dlgus0630/Project03_SelfDrivingCar/remote/Core/Src/main.c

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
/* Includes ------------------------------------------------------------------*/
#include "main.h"
#include "cmsis_os.h"
#include "can.h"
#include "i2c.h"
#include "usart.h"
#include "gpio.h"

/* USER CODE BEGIN Includes */
#include <stdio.h>
/* USER CODE END Includes */

/* USER CODE BEGIN PD */
/* CAN 수신 원형 버퍼의 칸 수.
   인터럽트가 빠르게 받아 담아두고 태스크가 천천히 꺼내 가므로
   잠깐 몰리는 것만 견디면 되어 8칸이면 충분하다. */
#define CAN_RX_RING_SIZE   8u
/* USER CODE END PD */


/* USER CODE BEGIN PV */
/* ===== CAN 수신 원형 버퍼 =====
   수신 인터럽트(ISR)가 head 를 밀면서 쓰고,
   CanRxTask 가 tail 을 밀면서 읽는다.
   쓰는 쪽 하나, 읽는 쪽 하나뿐이므로(생산자 1 : 소비자 1)
   인터럽트를 잠그지 않아도 서로 충돌하지 않는다.
   인터럽트가 값을 바꾸는 변수들이므로 컴파일러가 레지스터에
   캐시해 두지 못하도록 전부 volatile 로 선언한다. */
static volatile CanRxFrame_t g_can_ring[CAN_RX_RING_SIZE];
static volatile uint16_t     g_can_head     = 0;  /* 인터럽트가 다음에 쓸 칸 */
static volatile uint16_t     g_can_tail     = 0;  /* 태스크가 다음에 읽을 칸 */
static volatile uint32_t     g_can_total    = 0;  /* 총 수신 개수 */
static volatile uint32_t     g_can_overflow = 0;  /* 버퍼가 꽉 차서 버린 개수 */

/* ===== 디버거 관찰용 진단 변수 (Live Expressions) =====
   USB-TTL 시리얼 어댑터가 없어 printf 출력을 볼 수 없을 때,
   STM32CubeIDE 의 Live Expressions 창(디버깅 중에 변수 값을 실시간으로 보는 기능)에
   아래 이름을 그대로 적어 넣으면 값이 보인다.

   주의 1) static 을 붙이지 않는다.
             static 은 "이 파일 안에서만 보이게 하라"는 뜻이라,
             디버거가 이름으로 변수를 못 찾는 경우가 생긴다.
   주의 2) volatile 은 반드시 붙인다.
             이것이 없으면 컴파일러가 "어차피 아무도 안 읽는 값"이라고 판단해
             대입 문장 자체를 지워버리거나 레지스터에만 담아두어
             메모리를 들여다보는 디버거에게는 엉뚱한 값이 보인다. */

/* I2C 스캔에서 응답한 장치 총 개수 */
volatile uint8_t  g_diag_i2c_found        = 0u;
/* 응답한 주소 목록 (최대 8개까지, 나머지 칸은 0) */
volatile uint8_t  g_diag_i2c_addr[8]      = {0u};
/* IMU 주소. 0x68 이 응답하면 0x68, 못 찾으면 0 */
volatile uint8_t  g_diag_imu_addr         = 0u;
/* WHO_AM_I(0x75) 레지스터에서 읽은 값. 못 읽으면 0xFF */
volatile uint8_t  g_diag_who_am_i         = 0xFFu;
/* 칩이 어떤 모델인지 판별한 결과 코드
     0 = 못 찾음
     1 = MPU-9250 (WHO_AM_I 값 0x71, 9축·나침반 있음)
     2 = MPU-9255 (WHO_AM_I 값 0x73, 9축·나침반 있음)
     3 = MPU-6500 (WHO_AM_I 값 0x70, 6축·나침반 없음)
     4 = MPU-6050 (WHO_AM_I 값 0x68, 6축·나침반 없음)
     9 = 알 수 없는 칩 */
volatile uint8_t  g_diag_imu_kind         = 0u;
/* I2C 스캔이 끝나면 1 이 된다 */
volatile uint8_t  g_diag_scan_done        = 0u;

/* CAN 총 수신 개수 */
volatile uint32_t g_diag_can_total        = 0u;
/* 마지막으로 받은 프레임의 ID */
volatile uint32_t g_diag_can_last_id      = 0u;
/* 마지막으로 받은 프레임의 데이터 길이 (0~8) */
volatile uint8_t  g_diag_can_last_dlc     = 0u;
/* 마지막으로 받은 프레임의 데이터 8바이트 */
volatile uint8_t  g_diag_can_last_data[8] = {0u};
/* 직전 1초 동안 받은 개수 */
volatile uint32_t g_diag_can_per_sec      = 0u;

/* ===== CAN 통신 장애 원인 판별용 진단 변수 =====
   수신이 전혀 안 될 때(g_diag_can_per_sec 가 계속 0),
   원인이 "MCU 안쪽 설정"인지 "바깥 배선·트랜시버·상대 노드"인지
   갈라내기 위한 값들이다. 전부 Live Expressions 로 관찰한다.
   앞의 진단 변수들과 같은 이유로 static 을 붙이지 않고 volatile 만 붙인다. */

/* HAL_CAN_Start() 가 성공해서 지금 정상 모드로 돌고 있으면 1, 아니면 0 */
volatile uint8_t  g_diag_can_started      = 0u;
/* 수신 필터 설정(HAL_CAN_ConfigFilter)이 성공했으면 1 */
volatile uint8_t  g_diag_can_filter_ok    = 0u;
/* 수신 인터럽트 켜기(HAL_CAN_ActivateNotification)가 성공했으면 1 */
volatile uint8_t  g_diag_can_notify_ok    = 0u;

/* ===== CAN_ESR(오류 상태 레지스터)에서 뽑아낸 값들 =====
   RM0008(STM32F1 참조매뉴얼)의 CAN_ESR 비트 배치는 다음과 같다.
     비트 31~24 : REC[7:0]  수신 오류 카운터
     비트 23~16 : TEC[7:0]  송신 오류 카운터
     비트  6~4  : LEC[2:0]  마지막 오류 코드
     비트  3    : (예약, 쓰지 않음)
     비트  2    : BOFF      버스오프 상태
     비트  1    : EPVF      오류 수동(Error Passive) 상태
     비트  0    : EWGF      오류 경고(Error Warning) 상태
   [확인 기록] 작업 지시서의 표에는 TEC 가 24~31비트, REC 가 16~23비트라고
   적혀 있었으나 이는 둘이 서로 뒤바뀐 것이다. RM0008 기준으로는 위가 맞다.
   그래서 값을 뽑아내는 코드도 TEC 는 16비트에서, REC 는 24비트에서
   잘라내도록 해 두었다(freertos.c 의 Can_UpdateErrorDiag 참고). */

/* 송신 오류 카운터 (ESR 비트 23~16).
   보낸 프레임이 실패할 때마다 8씩 오른다.
   아무도 응답(ACK)해 주지 않는 상황이면 순식간에 128 까지 치솟는다. */
volatile uint8_t  g_diag_can_tec          = 0u;
/* 수신 오류 카운터 (ESR 비트 31~24).
   받는 쪽에서 어긋난 프레임을 볼 때마다 오른다.
   상대가 아예 아무것도 안 보내면 이 값은 0 에서 그대로 멈춰 있다. */
volatile uint8_t  g_diag_can_rec          = 0u;
/* 마지막 오류 코드 (ESR 비트 6~4). 값의 뜻은 아래 표와 같다.
     0 = 오류 없음
     1 = 스터프 오류 (같은 값이 6비트 내리 나왔다.
                      두 노드의 통신 속도(보율)가 서로 다를 때 잘 난다)
     2 = 폼 오류     (프레임의 정해진 모양이 어긋났다)
     3 = ACK 오류    (응답해 주는 노드가 하나도 없다.
                      상대가 꺼져 있거나, 트랜시버·배선·종단저항 문제다)
     4 = 비트 리세시브 오류 (1 을 내보냈는데 버스에서는 0 으로 읽혔다)
     5 = 비트 도미넌트 오류 (0 을 내보냈는데 버스에서는 1 로 읽혔다.
                             보통 트랜시버가 안 물려 있거나 배선이 끊긴 경우다)
     6 = CRC 오류    (검사값이 어긋났다)
     7 = 소프트웨어가 직접 써 넣은 값 (하드웨어가 낸 오류가 아니다) */
volatile uint8_t  g_diag_can_lec          = 0u;
/* 버스오프 상태면 1 (ESR 비트 2).
   송신 오류가 255 를 넘어서 컨트롤러가 스스로 버스에서 빠져나간 상태다. */
volatile uint8_t  g_diag_can_boff         = 0u;
/* 오류 수동(Error Passive) 상태면 1 (ESR 비트 1) */
volatile uint8_t  g_diag_can_epvf         = 0u;
/* 오류 경고(Error Warning) 상태면 1 (ESR 비트 0) */
volatile uint8_t  g_diag_can_ewgf         = 0u;
/* ESR 레지스터를 가공하지 않은 원본값 그대로.
   위의 낱개 값들이 미덥지 않을 때 이 값을 직접 들여다보면 된다. */
volatile uint32_t g_diag_can_esr_raw      = 0u;
/* HAL_CAN_GetError() 가 알려주는, HAL 계층이 모아 둔 오류값 */
volatile uint32_t g_diag_can_hal_err      = 0u;

/* ===== 루프백 자기진단 결과 =====
   루프백은 트랜시버도 바깥 배선도 없이,
   자기가 내보낸 프레임을 자기가 되받아 보는 시험 모드다.
   여기서 성공(1)이 나오면 클럭·비트타이밍(통신 속도)·필터·인터럽트 같은
   MCU 안쪽 설정이 전부 정상이라는 뜻이고,
   남은 원인은 바깥(트랜시버·배선·종단저항·상대 노드)뿐으로 좁혀진다.
     0 = 아직 실행 안 함
     1 = 성공 (MCU 안쪽은 정상)
     2 = 송신 실패 (송신함에 프레임을 넣지 못했다)
     3 = 수신 타임아웃 (내보냈지만 100ms 안에 되돌아오지 않았다)
     4 = 시험용 프레임이 안 되돌아옴 (남의 프레임은 들어왔지만,
         내가 보낸 0x7FF 시험용 프레임은 100ms 안에 되돌아오지 않았다)
     5 = 수신함에서 꺼내기 실패 (수신함에 뭔가 들어오기는 했는데 꺼내는 데
         실패했고, 시험용 프레임도 끝내 되돌아오지 않았다. 3 과 달리
         "아무것도 안 왔다"가 아니므로 배선이 아니라 수신함을 다루는 쪽을 본다) */
volatile uint8_t  g_diag_can_loopback     = 0u;
/* 루프백 시험을 마치고 정상 모드로 되돌리는 데 성공했으면 1.
   이 값이 0 이면 이후 통신이 영영 안 되는 상태이므로 가장 먼저 확인해야 한다. */
volatile uint8_t  g_diag_can_restore_ok   = 0u;
/* 버스오프에서 소프트웨어로 되살리는 데 온전히 성공한 횟수.
   시도만 하고 실패한 것은 세지 않는다. 실패는 g_diag_can_stuck 이 알려 준다. */
volatile uint32_t g_diag_can_recover_cnt  = 0u;
/* CAN 손잡이(hcan)가 리셋 없이는 되살릴 수 없는 상태에 빠졌으면 1.
   HAL_CAN_Stop() 은 손잡이 상태가 LISTENING 일 때만, HAL_CAN_Start() 는
   READY 일 때만 실제로 하드웨어를 건드린다. 그 밖의 상태에서는 아무 일도
   하지 않고 곧바로 오류만 돌려준다. 그래서 한 번 어긋난 상태로 굳어 버리면
   1초마다 다시 시도해 봐야 매번 헛물만 켤 뿐이고, g_diag_can_recover_cnt 는
   조금도 늘지 않고 그 자리에 멈춰 있는다. 온전히 되살아난 횟수만 세는 값이라
   실패한 시도는 아무리 되풀이해도 반영되지 않기 때문이다.
   Live Expressions 로 지켜볼 때 g_diag_can_stuck 이 1 인데 이 값이 멈춰 있다고
   해서 이상할 것이 없다. "몇 번 시도했는가"가 아니라 "몇 번 되살아났는가"다.
     1 = 그렇게 굳어 버린 상태라 Stop/Start 를 아예 시도조차 못 했거나,
         시도는 했지만 실패했다는 뜻이다. 이때는 MCU 를 리셋해야 풀린다.
     0 = 그런 상태가 아니다.
   지금 형편을 그대로 비추는 값이라, 나중에 복구가 온전히 성공하면 다시 0 이 된다. */
volatile uint8_t  g_diag_can_stuck        = 0u;
/* USER CODE END PV */

void SystemClock_Config(void);
void MX_FREERTOS_Init(void);
/**
  * @brief  The application entry point.
  * @retval int
  */
int main(void)
{

  /* MCU Configuration--------------------------------------------------------*/

  /* Reset of all peripherals, Initializes the Flash interface and the Systick. */
  HAL_Init();

  /* Configure the system clock */
  SystemClock_Config();

  /* Initialize all configured peripherals */
  MX_GPIO_Init();
  MX_CAN_Init();
  MX_I2C1_Init();
  MX_USART1_UART_Init();
  /* USER CODE BEGIN 2 */
  /* printf 로 찍은 글자가 버퍼에 쌓여 있다가 화면에 안 나오는 일을 막는다.
     _IONBF 는 "버퍼를 쓰지 않는다"는 뜻으로, 한 글자 생길 때마다 바로 보낸다.
     진단용 코드에서는 보드가 멈춰버려도 그 직전까지 찍힌 내용이
     그대로 남아 있어야 원인을 찾을 수 있다. */
  setvbuf(stdout, NULL, _IONBF, 0);

  /* 부팅 배너 - 지금 켜진 보드가 어느 쪽인지 한눈에 알아보기 위한 것 */
  printf("\r\n========================================\r\n");
  printf(" Project03_Remote (조종 노드) 시작\r\n");
  printf(" CAN 500kbps / I2C1 400kHz / UART 115200\r\n");
  printf("========================================\r\n");

  /* ===== CAN 수신 필터 설정 =====
     마스크를 0으로 두면 ID 를 비교하는 자리가 하나도 없어져서
     결과적으로 모든 ID 가 통과한다.
     지금은 진단이 목적이라 버스에 실제로 어떤 ID 가 흐르고 있는지를
     눈으로 전부 확인해야 하므로 일부러 전부 통과시킨다. */
  CAN_FilterTypeDef can_filter = {0};
  can_filter.FilterBank           = 0;
  can_filter.FilterMode           = CAN_FILTERMODE_IDMASK;
  can_filter.FilterScale          = CAN_FILTERSCALE_32BIT;
  can_filter.FilterIdHigh         = 0x0000;
  can_filter.FilterIdLow          = 0x0000;
  can_filter.FilterMaskIdHigh     = 0x0000;   /* 마스크 0 = 전부 통과 */
  can_filter.FilterMaskIdLow      = 0x0000;
  can_filter.FilterFIFOAssignment = CAN_FILTER_FIFO0;
  can_filter.FilterActivation     = ENABLE;
  can_filter.SlaveStartFilterBank = 14;

  /* 아래 세 가지는 실패하더라도 Error_Handler() 로 보내지 않는다.
     Error_Handler() 는 인터럽트를 모두 끄고 무한루프에 갇히기 때문에,
     CAN 트랜시버를 연결하지 않은 채 전원을 켜면 보드가 통째로 먹통이 되어
     UART 로그조차 한 줄도 안 나온다. 그러면 무엇이 잘못됐는지 알 수 없다.
     그래서 실패했다는 사실만 화면에 알리고,
     나머지 진단(I2C 스캔 등)은 그대로 이어서 진행하도록 한다. */
  if (HAL_CAN_ConfigFilter(&hcan, &can_filter) != HAL_OK)
  {
    printf("[CAN] 필터 설정 실패 (그래도 계속 진행합니다)\r\n");
  }
  else
  {
    g_diag_can_filter_ok = 1u;   /* 디버거에서 볼 수 있게 성공 여부를 남긴다 */
  }
  if (HAL_CAN_Start(&hcan) != HAL_OK)
  {
    printf("[CAN] 시작 실패 - 트랜시버 연결과 배선을 확인하세요 (그래도 계속 진행합니다)\r\n");
  }
  else
  {
    g_diag_can_started = 1u;
  }
  if (HAL_CAN_ActivateNotification(&hcan, CAN_IT_RX_FIFO0_MSG_PENDING) != HAL_OK)
  {
    printf("[CAN] 수신 인터럽트 켜기 실패 (그래도 계속 진행합니다)\r\n");
  }
  else
  {
    g_diag_can_notify_ok = 1u;
    printf("[CAN] 준비 완료 - 모든 ID 를 통과시키는 필터로 대기합니다\r\n");
  }
  /* USER CODE END 2 */

  /* Call init function for freertos objects (in cmsis_os2.c) */
  MX_FREERTOS_Init();

  /* Start scheduler */
  osKernelStart();

  /* We should never get here as control is now taken by the scheduler */

  /* Infinite loop */
  /* USER CODE BEGIN WHILE */
  while (1)
  {
    /* USER CODE END WHILE */

    /* USER CODE BEGIN 3 */
  }
  /* USER CODE END 3 */
}

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
/* USER CODE BEGIN 4 */
/**
  * @brief  printf 가 글자 하나를 내보낼 때 호출되는 함수.
  *         syscalls.c 안의 _write() 가 글자마다 이 함수를 부른다.
  *         여기서 USART1 로 실제 전송하므로, 이 함수만 있으면
  *         printf 출력이 디버그용 시리얼 창에 그대로 나타난다.
  */
int __io_putchar(int ch)
{
  /* ch 는 int 지만 실제로 보낼 것은 맨 아래 1바이트뿐이다 */
  HAL_UART_Transmit(&huart1, (uint8_t *)&ch, 1, 100);
  return ch;
}

/**
  * @brief  CAN 수신 FIFO0 에 프레임이 도착했을 때 자동으로 불리는 함수(인터럽트).
  *
  *         [중요] 이 안에서는 절대로 printf 를 부르지 않는다.
  *         printf 는 UART 로 한 글자씩 다 나갈 때까지 기다리는 방식이라
  *         인터럽트가 그만큼 오래 붙잡혀 있게 되고,
  *         그 사이에 들어온 다음 프레임을 놓쳐버린다.
  *         그래서 여기서는 원형 버퍼에 담아두고 개수만 세고 곧바로 빠져나오며,
  *         실제 화면 출력은 CanRxTask 가 여유 있을 때 대신 처리한다.
  */
void HAL_CAN_RxFifo0MsgPendingCallback(CAN_HandleTypeDef *hcan_arg)
{
  CAN_RxHeaderTypeDef header;
  uint8_t             rx_data[8];
  uint16_t            head;
  uint16_t            next;
  uint8_t             i;

  /* 하드웨어 수신함에서 프레임을 꺼낸다 */
  if (HAL_CAN_GetRxMessage(hcan_arg, CAN_RX_FIFO0, &header, rx_data) != HAL_OK)
  {
    return;
  }

  /* 총 수신 개수는 버퍼가 꽉 찼든 아니든 항상 센다 */
  g_can_total++;

  /* 디버거(Live Expressions)로 볼 진단용 값도 여기서 같이 갱신한다.
     인터럽트 안이므로 printf 는 절대 부르지 않고 단순 대입만 한다.
     아래는 원형 버퍼가 가득 차서 버리는 경우보다 앞에 두었다.
     버려지더라도 "버스에 지금 무엇이 흘러오는가"는 보여야 하기 때문이다. */
  g_diag_can_total    = g_can_total;
  g_diag_can_last_id  = (header.IDE == CAN_ID_STD) ? header.StdId : header.ExtId;
  g_diag_can_last_dlc = (uint8_t)header.DLC;
  for (i = 0u; i < 8u; i++)
  {
    g_diag_can_last_data[i] = rx_data[i];
  }

  head = g_can_head;
  next = (uint16_t)(head + 1u);
  if (next >= CAN_RX_RING_SIZE)
  {
    next = 0u;
  }

  if (next == g_can_tail)
  {
    /* 버퍼가 가득 찼다. 이번 프레임은 버리고 버린 개수만 따로 센다. */
    g_can_overflow++;
    return;
  }

  if (header.IDE == CAN_ID_STD)
  {
    g_can_ring[head].Id    = header.StdId;   /* 표준 11비트 ID */
    g_can_ring[head].IsExt = 0u;
  }
  else
  {
    g_can_ring[head].Id    = header.ExtId;   /* 확장 29비트 ID */
    g_can_ring[head].IsExt = 1u;
  }
  g_can_ring[head].Dlc = (uint8_t)header.DLC;

  for (i = 0u; i < 8u; i++)
  {
    g_can_ring[head].Data[i] = rx_data[i];
  }

  /* 내용을 다 채운 뒤에 마지막으로 head 를 옮긴다.
     읽는 쪽이 아직 덜 채워진 칸을 먼저 보게 되는 것을 막기 위한 순서다. */
  g_can_head = next;
}

/**
  * @brief  원형 버퍼에서 CAN 프레임을 하나 꺼낸다. (CanRxTask 전용)
  * @retval 1 = 하나 꺼냈음, 0 = 버퍼가 비어 있음
  */
uint8_t CanRx_Pop(CanRxFrame_t *out)
{
  uint16_t tail;
  uint8_t  i;

  if (out == NULL)
  {
    return 0u;
  }

  tail = g_can_tail;
  if (tail == g_can_head)
  {
    return 0u;   /* 비어 있음 */
  }

  /* volatile 인 버퍼에서 일반 변수로 한 항목씩 옮겨 담는다 */
  out->Id    = g_can_ring[tail].Id;
  out->IsExt = g_can_ring[tail].IsExt;
  out->Dlc   = g_can_ring[tail].Dlc;
  for (i = 0u; i < 8u; i++)
  {
    out->Data[i] = g_can_ring[tail].Data[i];
  }

  tail = (uint16_t)(tail + 1u);
  if (tail >= CAN_RX_RING_SIZE)
  {
    tail = 0u;
  }
  g_can_tail = tail;   /* 다 옮긴 뒤에 tail 을 옮긴다 */

  return 1u;
}

/**
  * @brief  부팅 후 지금까지 받은 CAN 프레임 총 개수를 알려준다.
  */
uint32_t CanRx_GetTotal(void)
{
  return g_can_total;
}

/**
  * @brief  원형 버퍼가 가득 차서 버려진 프레임 개수를 알려준다.
  *         이 값이 계속 늘어난다면 출력이 수신 속도를 못 따라가고 있다는 뜻이다.
  */
uint32_t CanRx_GetOverflow(void)
{
  return g_can_overflow;
}
/* USER CODE END 4 */
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
