dlgus0630/Project03_SelfDrivingCar/vehicle/ASW/Inc/asw_autonomous.h

/*
 * asw_autonomous.h
 *
 *  Layer  : ASW (Application Software)
 *  Module : ASW_AUTONOMOUS
 *  Desc   : 3개 초음파 센서(좌/전/우) 거리값을 기반으로 한
 *           독립적 자율주행(미로 통과) 판단 로직.
 *           위험/경고 임계값은 "주행 정책"이므로 Driver가 아닌
 *           본 Application 계층에서 관리한다.
 *
 *  Naming Rule : ASW_Autonomous_<Verb><Object>()
 */

#ifndef __ASW_AUTONOMOUS_H
#define __ASW_AUTONOMOUS_H

#include <stdint.h>

/* ------------------------------------------------------------------------
 * 자율주행 판단 임계값 (cm)
 * ------------------------------------------------------------------------ */
#define ASW_AUTO_DIST_EMERGENCY_CM   18u   /* 전방이 이 값 이하 = 아크로도 못 도는 상황,
                                             * 제자리 피벗(비상)으로 전환
                                             * [12->18] 전방 센서는 트리거 순환(좌->전->우,
                                             * 65ms 간격) 때문에 실제로 약 195ms에 한 번만
                                             * 갱신된다. 그 사이 전진한 거리만큼 임계값을
                                             * 앞당겨 반응 시간을 확보 */
#define ASW_AUTO_DIST_TURN_ENTER_CM  48u   /* 전방이 이 값 이하 = 코너 도착,
                                             * 주행을 멈추지 않고 아크 선회 시작
                                             * [36->48] 위와 동일 - 센서 갱신 지연(195ms)
                                             * 동안 전진하는 거리를 선반영해 "벽에 닿은 뒤
                                             * 회전"하는 현상 제거 */
#define ASW_AUTO_DIST_WARNING_CM     30u   /* 후진 회복 완료 판정 등 일반 경고 거리 */
#define ASW_AUTO_DIST_SIDE_BLOCK_CM  10u   /* 좌/우가 모두 이 값 이하 = 회전 여유조차
                                             * 없음 -> 후진 (좁은 통로 오판 방지를 위해
                                             * 낮게 유지) */

/* ------------------------------------------------------------------------
 * 센서 필터링 (지수이동평균, EMA)
 * ------------------------------------------------------------------------ */
#define ASW_AUTO_FILT_FRONT_NEW_W    2u    /* 전방: new 1/2 반영 (반응성 우선) */
#define ASW_AUTO_FILT_SIDE_NEW_W     3u    /* 좌우: new 1/3 반영 */
#define ASW_AUTO_FILT_RISE_MAX_CM    12u   /* 필터값이 한 사이클에 증가할 수 있는 상한.
                                             * 초음파 타임아웃/난반사로 인한 "순간 뻥 뚫림"
                                             * 스파이크가 판단에 섞이는 것을 차단.
                                             * (가까워지는 방향은 안전을 위해 무제한 즉시 반영) */

/* ------------------------------------------------------------------------
 * DRIVE 상태 : 직선 주행 (PD 센터링 + 전방거리 비례 속도)
 * ------------------------------------------------------------------------ */
#define ASW_AUTO_DRIVE_BASE_DUTY     560u  /* 전방 개방 시 최고 속도
                                             * [660->560, 약 15% 감속] 센서 갱신 지연
                                             * 195ms 동안 전진하는 거리 자체를 줄여
                                             * 정지거리를 단축 (반응 시간 확보) */
#define ASW_AUTO_DRIVE_SLOW_DUTY     430u  /* 코너 진입 직전 최저 전진 속도
                                             * (최저 유지값이므로 낮추지 않음 - 더 낮추면
                                             *  L298N 전압강하로 정지마찰을 못 이김) */
#define ASW_AUTO_SPEED_FULL_CM       85u   /* 전방이 이 값 이상이면 최고 속도,
                                             * TURN_ENTER~이 값 사이 선형 보간 감속
                                             * [60->85] TURN_ENTER 상향에 비례해 감속 시작
                                             * 지점도 앞당겨, 코너 도착 전에 충분히 감속 */
#define ASW_AUTO_CENTER_TRUST_CM     60u   /* 이보다 먼 거리는 '벽 없음', 이 값으로 클램프 */
#define ASW_AUTO_CENTER_KP           5u    /* 좌우 거리차 1cm당 보정 duty (P항)
                                             * [3->5] 2차 주행에서 통로 한쪽 벽에 붙어
                                             * 긁히는 현상 -> 센터링 복원력 강화 */
#define ASW_AUTO_CENTER_KD           28u   /* 거리차 변화량당 보정 duty (D항, 위빙 감쇠)
                                             * [20->28] KP 상향에 맞춰 감쇠도 같이 올려
                                             * 위빙(좌우 흔들림) 없이 센터링만 빨라지게 */
#define ASW_AUTO_CENTER_DEADBAND_CM  3     /* |좌-우| 이하이면 보정 0 */
#define ASW_AUTO_CENTER_MAX_CORR     140u  /* 센터링 보정 상한
                                             * [110->140] 게인만 올리고 상한을 그대로 두면
                                             * 곧바로 클리핑돼 강화 효과가 사라진다 */
#define ASW_AUTO_CENTER_DDIFF_MAX    6     /* D항에 넣는 거리차 변화량 상한 (cm/사이클).
                                             * 실제 주행에서 한 사이클에 생길 수 있는 기하학적
                                             * 변화는 2~3cm뿐 - 그 이상은 벽 모서리 통과 등
                                             * "이벤트"이므로 조향 신호로 쓰지 않는다 */
#define ASW_AUTO_STEER_SLEW          70    /* 사이클당 조향 보정 변화 상한 (duty).
                                             * 센서 점프로 인한 조향 채찍질(zigzag) 방지 */
#define ASW_AUTO_DUTY_MIN            220u  /* 센터링 중 바퀴 최소 duty */
#define ASW_AUTO_DUTY_SLEW_STEP      120u  /* 사이클(50ms)당 duty 최대 변화량 */

/* ------------------------------------------------------------------------
 * 회전 방향 투표 (접근 구간 적분)
 *  - 코너에 닿는 "순간"의 좌/우 한 쌍만 보고 방향을 정하면 대각선 박스
 *    난반사 한 방에 오판 -> 반대로 돌아 왔던 길로 U턴(출발지 복귀)한다.
 *  - 전방이 VOTE_CM 미만으로 좁아지는 접근 구간 동안 (좌-우)를 매 사이클
 *    적분한 점수로 방향을 결정 -> 순간 노이즈/난반사에 강함
 * ------------------------------------------------------------------------ */
#define ASW_AUTO_VOTE_CM             65u   /* 전방이 이 값 미만일 때 투표 적분 */
#define ASW_AUTO_VOTE_CLAMP          25    /* 사이클당 (좌-우) 기여 상한 (cm) */
#define ASW_AUTO_VOTE_TH             30    /* |점수|가 이 값 이상일 때만 투표 신뢰,
                                             * 미만이면 진입 순간의 넓은 쪽 사용 */
#define ASW_AUTO_GAP_DECISIVE_CM     30    /* 결정 순간 좌우 차이가 이 이상이면(한쪽이
                                             * 통로 입구처럼 확실히 열림) 적분 점수보다
                                             * 현재값을 우선 (상승제한 필터를 통과한 값이라
                                             * 순간 난반사로는 이만큼 벌어질 수 없음) */
#define ASW_AUTO_DIR_LOCK_MS         800u  /* (아래 주석 참조) */
#define ASW_AUTO_VOTE_OPEN_CM        45    /* 좌/우 중 한쪽이 이 값 이상일 때만 투표 적분.
                                             * 통로 안 양쪽 벽의 사소한 비대칭(13 vs 26cm 등)은
                                             * 방향 근거가 아님 - "입구가 보인다"는 신호만 적분 */
#define ASW_AUTO_CREEP_DUTY          400u  /* 방향 미확정 상태로 코너에 도달했을 때
                                             * 개방 신호를 기다리며 저속 전진하는 속도 */
#define ASW_AUTO_CREEP_FLOOR_CM      26u   /* [20->26] EMERGENCY 상향(12->18)에 맞춰 같이
                                             * 올림. 그대로 두면 CREEP과 비상 피벗 사이
                                             * 여유가 2cm뿐이라 creep이 사실상 사라진다.
                                             * 전방이 이 값 이하가 되면 더 못 기다림 ->
                                             * 그 시점 최선의 정보로 회전 강제 확정 */  /* 직전 회전 종료 후 이 시간 안에 다시 회전이
                                             * 필요해지면 방향 재투표 없이 같은 방향 유지.
                                             * (S자 미로의 연속 코너 2개는 항상 같은 방향
                                             * 회전쌍 -> 중간에 방향이 뒤집히면 U턴) */

/* ------------------------------------------------------------------------
 * ARC_TURN 상태 : 무정지 아크(호) 선회 - 일반 코너의 기본 처리
 *  - 바깥쪽 바퀴 고속 / 안쪽 바퀴 저속으로 전진하며 도는 이동 선회.
 *    정지·피벗 없이 코너를 통과하므로 매끄럽고 빠르다.
 * ------------------------------------------------------------------------ */
#define ASW_AUTO_ARC_OUT_DUTY        520u  /* 바깥쪽 바퀴 duty
                                             * [620->520, 약 15% 감속] 선회 중 전방 센서
                                             * 갱신 지연 대비 - 선회 궤적을 줄여 반응 확보 */
#define ASW_AUTO_ARC_IN_DUTY         320u  /* 안쪽 바퀴 duty (작을수록 급선회)
                                             * (최저 유지값이므로 낮추지 않음) */
#define ASW_AUTO_ARC_EXIT_CM         54u   /* 전방이 이 값 초과(연속 확인)면 선회 종료
                                             * [42->54] TURN_ENTER(48)보다 반드시 커야 한다.
                                             * 작으면 선회 종료 직후 DRIVE가 곧바로 다시
                                             * 코너로 판정해 ARC를 재진입 -> 제자리 반복
                                             * (히스테리시스 +6cm를 기존과 동일하게 유지) */
#define ASW_AUTO_ARC_MIN_MS          200u  /* 최소 선회 유지시간 */
#define ASW_AUTO_ARC_MAX_MS          1500u /* 이 시간 내 전방이 안 열리면 피벗 전환 */

/* ------------------------------------------------------------------------
 * PIVOT 상태 : 제자리 피벗 - 비상시(막다른 코너/급접근)에만 사용
 *  - 방향은 투표로 잠근 방향 유지: 코너에서 올바른 쪽으로 돌면
 *    90도 부근에서 먼저 통로가 열리므로 180도(왔던 길)까지 갈 일이 없다
 * ------------------------------------------------------------------------ */
#define ASW_AUTO_PIVOT_DUTY          420u  /* 피벗 회전 속도 */
#define ASW_AUTO_PIVOT_EXIT_CM       52u   /* 전방이 이 값 초과(연속 확인)면 종료
                                             * [40->52] ARC_EXIT와 같은 이유로 TURN_ENTER(48)
                                             * 위에 두어 피벗 종료 직후 재진입(가다서다) 방지
                                             * (히스테리시스 +4cm를 기존과 동일하게 유지) */
#define ASW_AUTO_PIVOT_MIN_MS        150u  /* 최소 회전 유지시간 */
#define ASW_AUTO_PIVOT_EXPECT_MS     500u  /* 약 90도 회전 예상 소요시간(경험적 추정, 실측 보정 필요).
                                             * 이 시간이 지나도 PIVOT_EXIT_CM 기준을 못 채우면
                                             * 더 도는 대신 느슨한 기준(WARNING_CM)만으로 즉시
                                             * 복귀시켜 왔던 길까지 도는 U턴을 방지한다. */
#define ASW_AUTO_PIVOT_EXPECT_DEG    90.0f /* 위 EXPECT_MS 주석이 이미 말로 적어 둔 "약 90도 회전"
                                             * 가정을 그대로 숫자로 옮긴 값이다. 새로 잡은 임의의
                                             * 튜닝 상수가 아니라, remote IMU yaw로 실제 회전각을
                                             * 잴 수 있게 된 지금 그 가정을 명시적이고 측정 가능한
                                             * 형태로 드러낸 것 - 시간(EXPECT_MS)과 각도(EXPECT_DEG)는
                                             * 같은 "약 90도"를 서로 다른 단위로 표현한 짝이다. */
#define ASW_AUTO_PIVOT_IMU_MAX_AGE_MS 400u /* 각도 기반 과회전 가드가 yaw를 "살아있는 값"으로
                                             * 인정해 주는 최대 수신 경과시간.
                                             * remote IMU 자세는 CAN 0x120으로 약 100ms마다
                                             * 올라오므로 400ms는 프레임 약 4개를 놓쳐도
                                             * 버티는 여유다 - 평상시 지터(버스 혼잡, 한두 개
                                             * 유실)로는 각도 가드가 흔들리지 않을 만큼 길고,
                                             * 링크가 진짜로 죽었을 때는 여러 번의 피벗에
                                             * 걸쳐서가 아니라 그 피벗 안에서 곧바로 감지될
                                             * 만큼 짧다. */
#define ASW_AUTO_PIVOT_MAX_MS        1700u /* 초과 시 '갇힘' -> BACKING_UP */
#define ASW_AUTO_EXIT_CONFIRM        2u    /* 개방 연속 확인 사이클 수 (ARC/PIVOT 공용) */

/* ------------------------------------------------------------------------
 * BACKING_UP 상태 : 연속 후진 회복 (최후 수단)
 * ------------------------------------------------------------------------ */
#define ASW_AUTO_BACKUP_DUTY         450u  /* 후진 속도 */
#define ASW_AUTO_BACKUP_STEP_MS      250u  /* 재시도 카운트 1회로 치는 후진 시간 단위 */
#define ASW_AUTO_BACKUP_MAX_RETRY    3u    /* 누적 후진 한도 -> 반대 방향 피벗 재시도 */

/* CtrlTask의 osDelay(50)과 반드시 일치시켜야 하는 제어 주기 (freertos.c 참조) */
#define ASW_AUTO_CTRL_PERIOD_MS      50u

/* ------------------------------------------------------------------------
 * Public API
 * ------------------------------------------------------------------------ */
void ASW_Autonomous_Init(void);
void ASW_Autonomous_ProcessControl(uint32_t dist_left,
                                 uint32_t dist_front,
                                 uint32_t dist_right);

#endif /* __ASW_AUTONOMOUS_H */
