dlgus0630/Project03_SelfDrivingCar/remote/Core/Inc/mpu9255.h

/**
  ******************************************************************************
  * @file    mpu9255.h
  * @brief   MPU-9255 6축(가속도 + 자이로) 읽기와 상보필터 자세 추정 공개 창구
  ******************************************************************************
  * @attention
  *
  * 이 파일은 STM32CubeMX 가 만들어 주는 파일이 아니라 사람이 직접 쓴 파일이다.
  * 그래서 USER CODE 표시 구역이 따로 없고, 어디를 고쳐도 다시 만들기(Generate Code)
  * 때 지워지지 않는다.
  *
  * [센서를 어떻게 붙여 놓았는가]
  *   보드는 바닥에 평평하게(수평으로) 눕혀 놓았고,
  *   MPU 의 X축이 리모컨의 앞쪽(FRONT)을 향한다.
  *   센서 좌표계는 오른손 좌표계라서 이렇게 정리된다.
  *       X = 앞(forward),  Y = 왼쪽(left),  Z = 위(up)
  *   이 배치를 전제로 아래 상보필터의 roll / pitch 계산식이 세워져 있다.
  *
  * [이 단계에서 지자기(나침반)를 다루지 않는 이유]
  *   MPU-9255 안의 나침반(AK8963)은 같은 칩 안에 있어도 I2C 로는 곧바로 안 보인다.
  *   바이패스를 열거나 보조 I2C 마스터를 돌려야 겨우 읽히는데 손이 많이 간다.
  *   방위각(yaw)은 나침반 없이 자이로 Z축을 적분하는 것만으로 따라간다.
  *   되잡아 줄 절대 기준이 없어 시간이 지나면 흘러가므로, 짧은 구간의
  *   회전량으로만 쓰고 절대 방위로는 쓰지 않는다. 그 용도라면 나침반이
  *   없어도 충분하므로, 나침반은 그대로 통째로 건너뛴다.
  ******************************************************************************
  */

/* Define to prevent recursive inclusion -------------------------------------*/
#ifndef __MPU9255_H__
#define __MPU9255_H__

#ifdef __cplusplus
extern "C" {
#endif

/* Includes ------------------------------------------------------------------*/
/* main.h 가 stm32f1xx_hal.h 를 끌어와 uint8_t / int16_t 같은 형과
   HAL 자료형을 모두 갖춰 준다. 이 헤더 하나만 include 해도 되도록 만들어 둔다. */
#include "main.h"

/* Exported constants --------------------------------------------------------*/

/* 9축 IMU 의 7비트 I2C 주소와, 어떤 칩인지 알려주는 레지스터 번호.
   [왜 이 둘만 헤더로 내놓는가]
   freertos.c 의 부팅 시 I2C 스캔이 이 드라이버를 거치지 않고 직접
   이 주소를 두드려 WHO_AM_I 를 읽어 본다. 스캔은 Mpu9255_Init() 보다
   먼저 도는 자리라 드라이버 함수를 부를 수 없기 때문이다.
   그렇다고 양쪽이 같은 숫자를 따로 적어 두면 한쪽만 고쳤을 때
   소리 없이 어긋나므로, 숫자만 여기 한 곳에 모아 둘이 같이 쓴다.
   (AD0 핀을 GND 에 붙였으므로 0x68 이다. 3.3V 에 붙였다면 0x69 가 된다) */
#define MPU9255_ADDR_7BIT         0x68u
#define MPU9255_REG_WHO_AM_I      0x75u

/* 좌우/앞뒤 기울기의 부호를 통째로 뒤집는 스위치.
   [왜 이런 스위치를 굳이 두는가]
   센서를 실제로 어느 방향으로 붙였는지는 프로젝트 주인이 "이렇게 붙였다"고
   말해 준 것을 그대로 믿고 적어 둔 것일 뿐, 책상 위에서 직접 기울여 보며
   확인한 적이 아직 한 번도 없다. 모듈을 180도 돌려 꽂았거나 뒤집어 붙였다면
   왼쪽으로 기울였는데 오른쪽 값이 나오는 식으로 부호만 정반대가 된다.
   그때 필터 수식을 건드리기 시작하면 수식이 금세 뒤엉켜서 무엇이 옳은지
   알 수 없게 된다. 그러니 실물 시험에서 좌우 또는 앞뒤가 거꾸로 나오거든
   수식은 그대로 두고 여기 값을 0 에서 1 로만 바꾸면 된다. */
#define IMU_ROLL_INVERT           0
#define IMU_PITCH_INVERT          0

/* 상보필터의 배분 비율.
   0.98 = 자이로(짧은 시간은 정확하지만 오래 두면 흘러간다) 98%,
          가속도(길게 보면 정확하지만 흔들림에 약하다) 2% 로 섞는다는 뜻이다. */
#define IMU_ALPHA                 0.98f

/* IMU 태스크가 한 번 도는 간격(밀리초). 20ms = 초당 50번 표본을 뜬다.
   freertos.c 의 osDelay() 도 이 값을 그대로 쓰므로 반드시 헤더에 있어야 한다. */
#define IMU_TASK_PERIOD_MS        20u

/* 한 번 도는 데 걸리는 시간을 초 단위 실수로 바꾼 값 (자이로 적분에 쓴다) */
#define IMU_DT_SEC                (IMU_TASK_PERIOD_MS / 1000.0f)

/* 라디안을 도(degree)로 바꾸는 상수.
   [M_PI 를 쓰지 않는 이유]
   M_PI 는 C 표준이 반드시 있으라고 정해 둔 이름이 아니다. 엄격한 표준 모드로
   컴파일하면 <math.h> 를 넣어도 M_PI 가 없어서 빌드가 통째로 깨진다.
   그래서 180/pi 를 미리 계산한 값을 직접 박아 두어 그럴 일을 아예 없앤다. */
#define IMU_RAD_TO_DEG            (57.2957795f)

/* Exported functions prototypes ---------------------------------------------*/

/* 센서를 깨우고 설정한 뒤, 자이로 영점(bias)까지 재는 초기화.
   자이로 영점 측정에 1초쯤 걸리므로 반드시 태스크 안에서 딱 한 번만 부른다.
   반환값 1 = 모든 단계 성공, 0 = 어느 한 단계라도 실패 */
uint8_t Mpu9255_Init(void);

/* 가속도와 자이로를 한 번씩 읽어 상보필터를 한 걸음 전진시킨다.
   IMU_TASK_PERIOD_MS 간격으로 규칙적으로 불러야 적분이 맞는다.
   반환값 1 = 이번 표본을 제대로 읽어 반영했음, 0 = I2C 읽기에 실패해 건너뜀 */
uint8_t Mpu9255_Update(void);

/* 지금까지 걸러낸 좌우 기울기(도 단위). IMU_ROLL_INVERT 가 이미 반영된 값이다. */
float   Mpu9255_GetRollDeg(void);

/* 지금까지 걸러낸 앞뒤 기울기(도 단위). IMU_PITCH_INVERT 가 이미 반영된 값이다. */
float   Mpu9255_GetPitchDeg(void);

/* 지금까지 자이로만 적분해 쌓은 방위각(도 단위, -180 ~ +180).
   위 둘과 달리 부호를 뒤집는 스위치가 없다. 쓰는 쪽이 회전량의 크기만 보기 때문이다.
   되잡아 주는 항이 없어 시간이 지나면 흘러가므로 짧은 구간의 차이로만 써야 한다. */
float   Mpu9255_GetYawDeg(void);

/* 자이로 영점 측정이 끝났으면 1, 아직이거나 실패했으면 0.
   CAN 상태 바이트의 0번 비트로 그대로 실려 나간다. */
uint8_t Mpu9255_IsCalibrated(void);

/* 초기화 때 읽어 둔 WHO_AM_I 값 (읽지 못했으면 0xFF).
   통신이 되는지 눈으로 확인하는 용도이며, 값이 달라도 동작을 막지는 않는다. */
uint8_t Mpu9255_GetWhoAmI(void);

#ifdef __cplusplus
}
#endif

#endif /* __MPU9255_H__ */
