dlgus0630/Project03_SelfDrivingCar/(commit log)

2026-08-15 Initial commit: STM32F103 자율주행 RC카 (CAN 3-노드 + FreeRTOS)
    - ASW/RTE/BSW/Core 4계층 구조 (AUTOSAR 스타일)
    - 자율주행 4-state FSM: DRIVE / ARC_TURN / PIVOT / BACKING_UP
    PD 센터링, EMA 센서 필터, 회전 방향 투표 알고리즘
    - FreeRTOS 태스크 4개 (TrigTask / CtrlTask / CanRxTask / CanTxTask)
    - CAN 3-노드 공유 버스 500kbps, Mail Queue 기반 ISR 브릿지
    - 블루투스(HC-06) 수동주행, 명령 출처별 무응답 타임아웃
    - README 작성 (아키텍처, 알고리즘, 핀맵, 상태전이, 트러블슈팅)
2026-08-15 README: 제목을 제외한 본문 이모지 제거
    - 안내/주의 문구의 장식 이모지 제거 (링크, 정보, 전구, 경고, 핀)
    - CAN ID 표의 체크/엑스 표기를 텍스트로 대체
    구현 여부는 '구현' / 'ID만 정의, 미구현' 문구로 그대로 유지
2026-08-18 라즈베리파이(Node3) 제거 - 2-노드 CAN 시스템으로 정정
    - mcal_can.h: RPI_AI_CMD(0x300) 정의 삭제, 2-노드 기준으로 주석 정정
    - mcal_can.c: RPi 대역 전용 FilterBank 1 삭제
    0x3xx를 처리하는 코드가 없고, 0x200/0x3F0은 본 노드가 송신하는
    ID라 수신 필터가 필요 없음
    - README: 제목·뱃지·소개·6장 CAN 섹션을 2-노드로 정정,
    14장 한계 표 4항목 -> 3항목 재번호화
2026-08-18 수동주행: 모르는 문자가 주행을 멈추던 문제 수정
    블루투스 앱이 보내는 부가 문자(속도 '0'~'9', 전조등 'W', 경적 'V' 등)가
    s_lastCmd를 덮어써서 ProcessControl의 default로 떨어져 차가 즉시 멈추고
    계속 멈춰 있었다.
    "링크 생존 확인"과 "주행 명령 변경"을 분리:
    - 아는 명령(F/B/L/R/S)일 때만 s_lastCmd 변경
    - 모르는 문자는 무시하되, 이미 SERIAL 출처면 타임스탬프만 갱신
    (바이트 수신 자체가 링크가 살아있다는 증거)
    - NONE 상태에서는 갱신하지 않아 잡음으로 감시가 시작되지 않게 함
    [asw_manual_control.c]
2026-08-18 프로젝트 구조 개편: master / slave 2-노드 분리
    차 한 대에 CAN 노드 2개가 올라가는 구조에 맞춰 저장소를 재편성.
    - slave/ : 검은 보드 (기존 차) - 모터·초음파·블루투스·자율주행
    - master/ : 파란 보드 (신규) - MPU-9250 자이로, 명령 송신
    - README.md, .gitignore는 시스템 공용으로 최상위 유지
    master는 CubeMX 생성 직후 상태이며 툴체인이 EWARM으로 잘못 지정돼
    있어 STM32CubeIDE로 재생성 필요. EWARM/·MDK-ARM/은 .gitignore에 추가.
2026-08-18 폴더명 변경: master/slave -> remote/vehicle
    "슬레이브"라는 이름이 실제 역할과 맞지 않았다. 차량 노드는 자율주행
    FSM·PD 센터링·센서 필터링·회전 방향 투표까지 판단의 대부분을 담당하며,
    조종 노드는 자이로를 읽어 자세값을 보내는 입력 장치에 가깝다.
    - master/ -> remote/ (조종 노드)
    - slave/ -> vehicle/ (차량 노드)
    - README 8장 폴더 트리를 2-노드 구조로 갱신
2026-08-18 remote: STM32CubeIDE 툴체인으로 재생성
    이전 생성분은 툴체인이 EWARM(IAR)으로 지정돼 있어 STM32CubeIDE에서
    열 수 없었다. STM32CubeIDE로 변경 후 재생성하여 .project/.cproject/
    .settings와 링커 스크립트를 확보.
    - LibraryCopy가 0(전체 복사) -> 1(필요한 것만)로 바뀌며 사용하지 않는
    기종의 CMSIS 헤더 다수가 빠짐. vehicle 프로젝트와 동일한 설정
    - 주변장치 설정은 변동 없음 (CAN 500kbps, I2C1 Fast, FreeRTOS 힙 6144)
2026-08-18 프로젝트명 정리: Project03_Vehicle / Project03_Remote
    Project02 저장소들의 명명 규칙(Project0N_PascalCase)에 맞추고,
    GitHub 저장소명(Project03_SelfDrivingCar)과 로컬 폴더명을 일치시켰다.
    - 최상위 폴더: Project03_Self-driving Car -> Project03_SelfDrivingCar
    - vehicle: Project03_Self-driving Car -> Project03_Vehicle
    - remote : Project03_GyroNode -> Project03_Remote
    - .ioc/.project/.cproject/.launch의 프로젝트명 참조 갱신
    - .launch와 CubeMX 리포트에 남아 있던 옛 절대경로 교정
    - README 폴더 트리의 파일명 표기 갱신
    CubeMX 재생성 없이 설정 파일만 직접 편집해 사용자 코드는 무변경.
    옛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
2026-08-18 remote: CAN 수신 + I2C 스캔 진단 코드 추가
    배선과 통신이 정상인지 먼저 확인하기 위한 1단계 진단용 코드.
    - I2C 버스 전체 스캔 후 응답 주소 출력, 0x68의 WHO_AM_I(0x75)를 읽어
    MPU-9250 / 9255 / 6500 / 6050 중 어느 칩인지 판별
    - CAN은 모든 ID를 통과시키는 필터로 열어 버스 실제 트래픽을 관찰
    - 수신 프레임은 ISR에서 원형 버퍼(8칸)에 적재만 하고 출력은 태스크에서
    500ms 간격으로 제한 (ISR 내 printf 금지 원칙 유지)
    - CAN 초기화 실패 시 Error_Handler() 무한루프 대신 원인을 출력하고 계속
    진행. 트랜시버 미연결 상태에서 보드가 먹통이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
    [main.c, main.h]
2026-08-18 remote: Live Expressions 관찰용 진단 전역 변수 추가
    USB-TTL 시리얼 어댑터가 없어 printf 출력을 볼 수 없는 환경이라,
    ST-Link 디버거의 Live Expressions로 진단할 수 있도록 결과를 전역
    변수에 담는다. 기존 printf 출력은 그대로 유지.
    - I2C 스캔 결과: g_diag_i2c_found, g_diag_i2c_addr[8], g_diag_imu_addr
    - 칩 판별: g_diag_who_am_i, g_diag_imu_kind (1=9250 2=9255 3=6500 4=6050)
    - CAN 수신: g_diag_can_total, g_diag_can_per_sec,
    g_diag_can_last_id/dlc/data[8]
    - 진행 표시: g_diag_scan_done
    디버거가 심볼을 이름으로 찾을 수 있도록 static 없이 선언(ELF 심볼
    테이블에서 전역으로 잡히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
2026-08-19 remote: CAN 장애 원인 판별용 진단 기능 추가
    수신이 전혀 안 되는데 배선은 정상이라는 상황에서, 원인이 MCU 안쪽인지
    바깥(트랜시버·배선·상대 노드)인지 갈라내기 위한 진단.
    - 루프백 자기진단: 부팅 시 트랜시버·버스 없이 자기 프레임을 자기가
    받아보고 결과를 g_diag_can_loopback에 기록. 성공이면 클럭·비트타이밍
    ·필터·인터럽트가 정상임이 확정되어 원인이 외부로 좁혀진다.
    시험 후 정상 모드 복귀 성공 여부는 g_diag_can_restore_ok로 확인
    - CAN_ESR 감시: TEC/REC 오류 카운터, LEC(마지막 오류 코드),
    버스오프·오류수동·오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
2026-08-19 vehicle: CAN 상태 진단 + 버스오프 소프트웨어 자동 복구
    상대 노드(remote)가 아무것도 수신하지 못하는 원인을 가려내기 위해,
    이 보드의 CAN 컨트롤러 상태를 Live Expressions로 관찰할 수 있게 한다.
    버스오프·오류수동·오류경고 플래그를 100ms 주기로 갱신
    - 송신 통계: tx_ok / tx_fail / 비어있는 송신 메일박스 수
    (MCAL_CAN_Transmit의 반환값과 기존 판정 로직은 변경하지 않음)
    - 버스오프 자동 복구: AutoBusOff가 꺼져 있어 한 번 빠지면 전원을
    껐다 켜기 전까지 송신이 영영 멈춘다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
2026-08-21 README: CAN 2-노드 구조(remote 9축 IMU + vehicle)로 갱신
    - 제목/소개/구성도를 2-노드 분산 제어 구조로 재작성
    - CAN ID 맵을 송신부/수신부로 분리, 0x120 IMU_ATTITUDE 추가
    - 미구현 항목(0x120, IMU 자세값, remote 송신부, 하트비트) 명시
    - remote 노드 핀맵/MPU-9255 배선/태스크 구성 추가
    - 설계 포인트에 루프백 자기진단, 버스오프 복구, Live Expressions 추가
    - Troubleshooting 13-2(부가 문자 정지, 해결) / 13-3(CAN 두절, 진행 중) 추가
    - 한계 4(CAN 미확립), 5(IMU 미구현) 추가
2026-09-03 차량 실물 사진을 README에 추가
2026-09-05 Add yaw-based pivot control and update README
2026-09-06 remote 자이로 yaw 적분 추가, 자율주행 피벗 판정을 각도 기반으로 개선
